Lucaxc/Master-Thesis-PtCO2/PCB/Board2.png

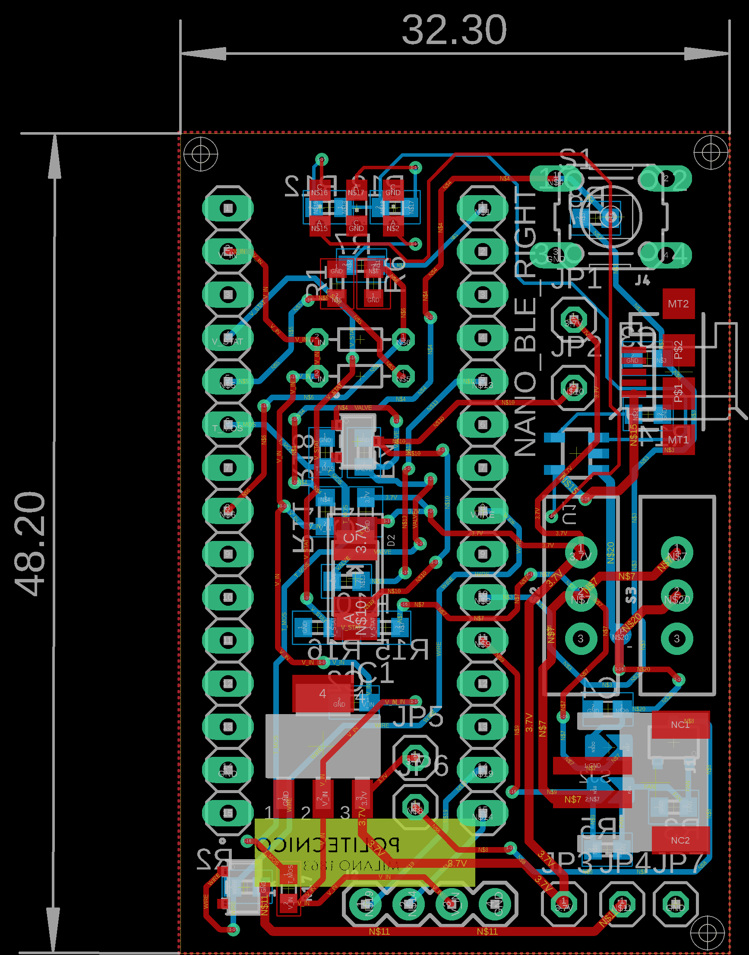
PCB/Board2.png
