Lucaxc/Master-Thesis-PtCO2/PCB/Ver_9.sch

## EAGLE design PCB/Ver_9.sch (2022-05-16)

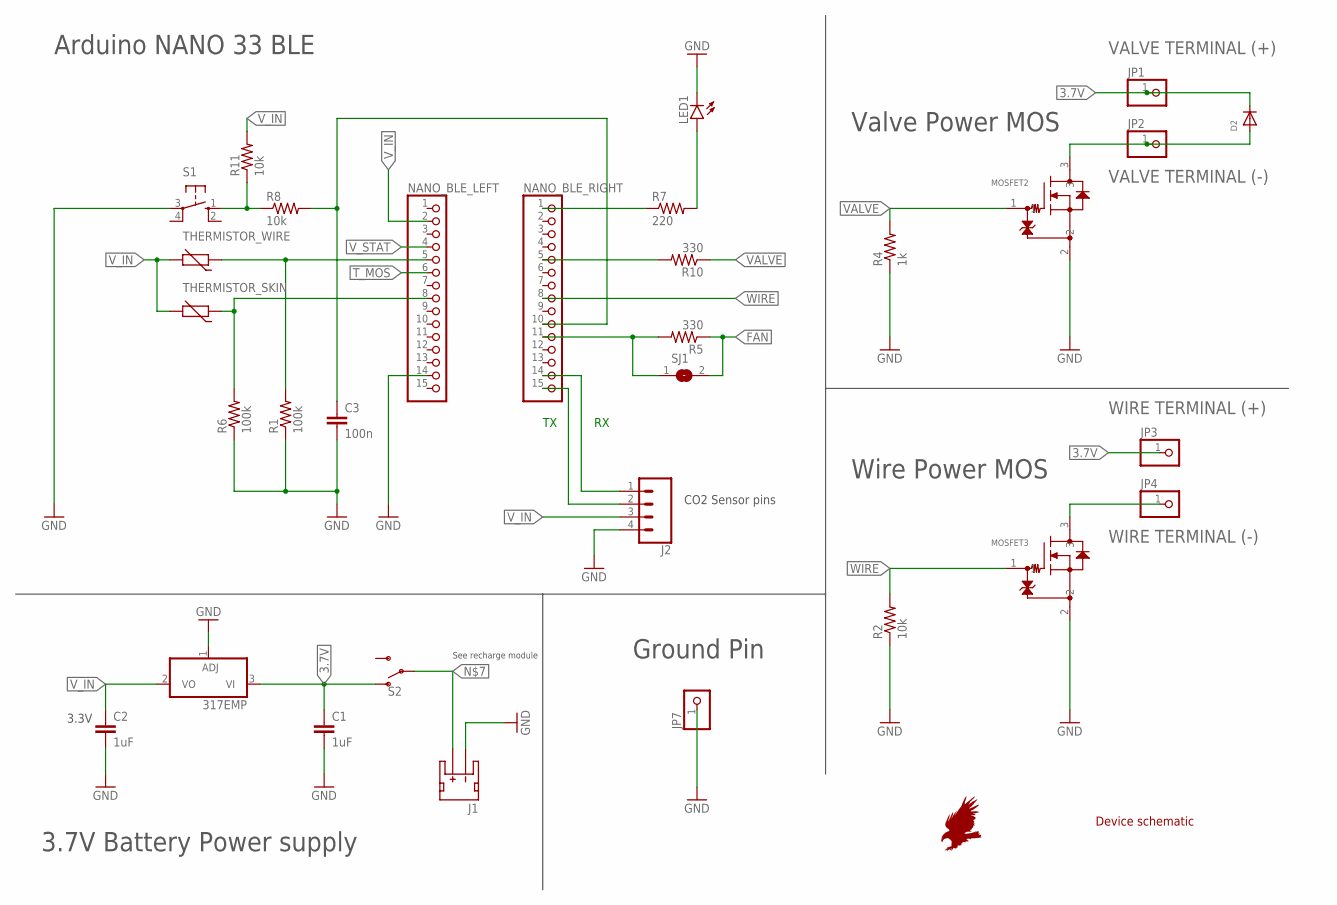
[picture p2: schematic Ver_9.sch, sheet 1]

Parts:
C1, C2: 1uF; C0603
C3: 100n; C0603
D2: DIODESMA; SMADIODE
IC1: 317EMP; SOT223
J1: JST_2MM_MALE; JST-2-SMD
J2: CONN_04; 1X04
JP1, JP2, JP3, JP4, JP7: PINHD-1X1; 1X01
LED1: LEDCHIPLED_0805; CHIPLED_0805
MOSFET2, MOSFET3: SSM3K2615RSOT-23F_TOS-M; SOT-23F_TOS-M
NANO_BLE_LEFT: PINHD-1X15; 1X15
NANO_BLE_RIGHT: PINHD-1X15; 1X15
R1, R6: 100k; R0603
R2, R8, R11: 10k; R0603
R4: 1k; R0603
R5, R10: 330; R0603
R7: 220; R0603
S1: 10-XX; B3F-10XX
S2: SWITCH-SPDT-PTH-11.6X4.0MM; SWITCH_SPDT_PTH_11.6X4.0MM
SJ1: SOLDERJUMPER; SOLDERJUMPER_ARROW_NOPASTE
THERMISTOR_SKIN: THERMISTOR-5; R-5
THERMISTOR_WIRE: THERMISTOR-5; R-5

Connections:
3.7V: C1.1, D2.C, IC1.3 (VI), JP1.1, JP3.1, S2.1 (O)
FAN: R5.1, SJ1.2
GND: C1.2, C2.2, C3.2, IC1.1 (ADJ), J1.1 (-), J2.4, JP7.1, LED1.C, MOSFET2.2, MOSFET3.2, NANO_BLE_LEFT.14, R1.1, R2.1, R4.1, R6.1, S1.3
unnamed: NANO_BLE_RIGHT.1, R7.1
unnamed: LED1.A, R7.2
unnamed: C3.1, NANO_BLE_RIGHT.10, R8.2
unnamed: R8.1, R11.1, S1.1 (S)
unnamed: NANO_BLE_LEFT.5, R1.2, THERMISTOR_WIRE.1
unnamed: NANO_BLE_LEFT.8, R6.2, THERMISTOR_SKIN.1
unnamed: J1.2 (+), S2.2
unnamed: NANO_BLE_RIGHT.11, R5.2, SJ1.1
unnamed: D2.A, JP2.1, MOSFET2.3
unnamed: JP4.1, MOSFET3.3
unnamed: NANO_BLE_RIGHT.5, R10.2
unnamed: J2.2, NANO_BLE_RIGHT.15
unnamed: J2.1, NANO_BLE_RIGHT.14
T_MOS: NANO_BLE_LEFT.6
VALVE: MOSFET2.1, R4.2, R10.1
V_IN: C2.1, IC1.2 (VO), J2.3, NANO_BLE_LEFT.2, R11.2, THERMISTOR_SKIN.2, THERMISTOR_WIRE.2
V_STAT: NANO_BLE_LEFT.4
WIRE: MOSFET3.1, NANO_BLE_RIGHT.8, R2.2

Notes on the sheet:
VALVE TERMINAL (+)
VALVE TERMINAL (-)
WIRE TERMINAL (+)
WIRE TERMINAL (-)
Valve Power MOS
Wire Power MOS
Arduino NANO 33 BLE
Ground Pin
3.3V
CO2 Sensor pins
3.7V Battery Power supply
Device schematic
See recharge module

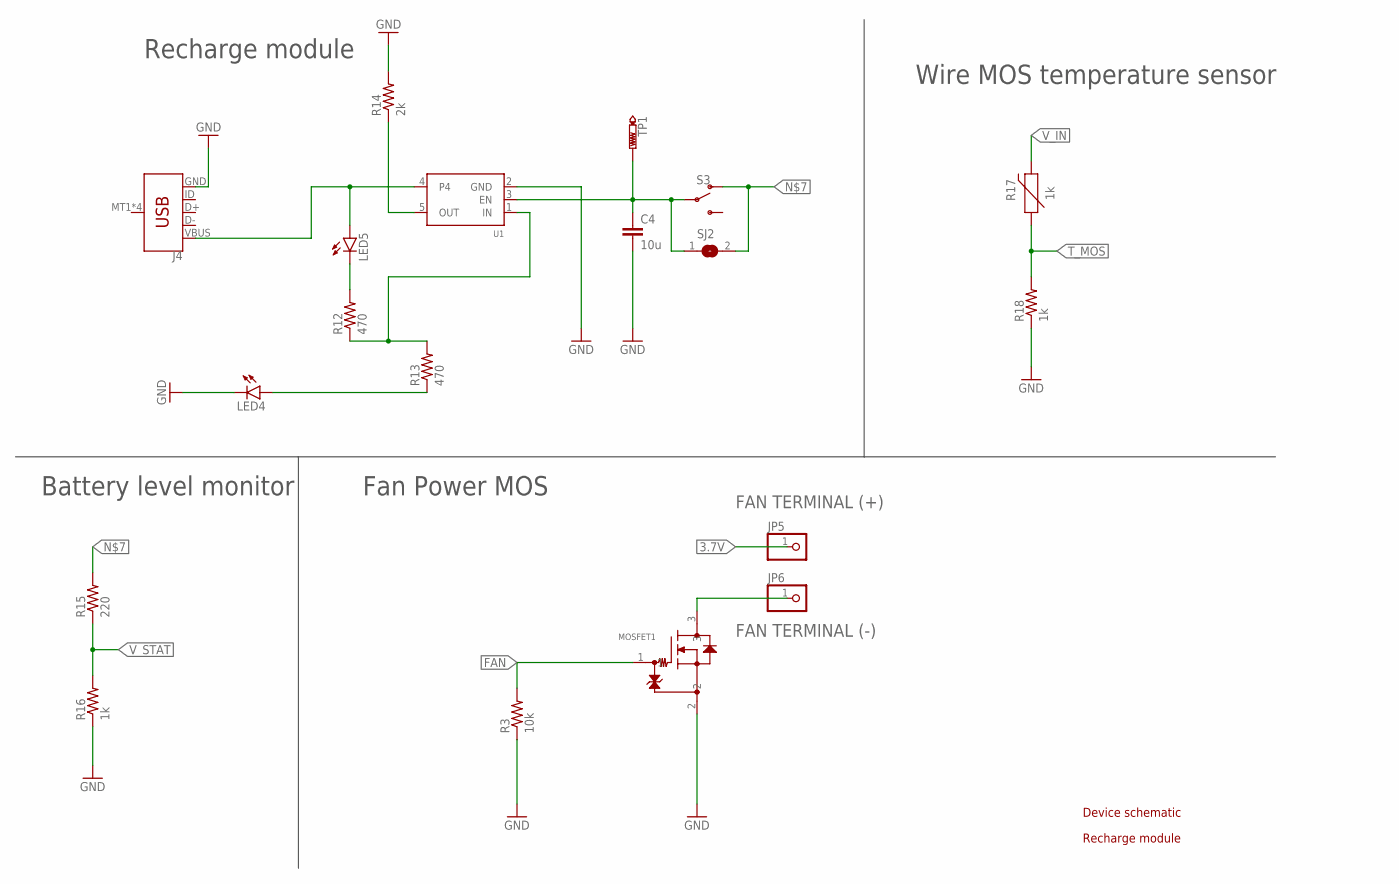
[picture p3: schematic Ver_9.sch, sheet 2]

Parts:
C4: 10u; C0603
J4: USB_MICRO-B_SMT; USB-MICROB
JP5, JP6: PINHD-1X1; 1X01
LED4, LED5: LEDCHIPLED_0805; CHIPLED_0805
MOSFET1: SSM3K2615RSOT-23F_TOS-M; SOT-23F_TOS-M
R3: 10k; R0603
R12, R13: 470; R0603
R14: 2k; R0603
R15: 220; R0603
R16, R18: 1k; R0603
R17: 1k; 0603
S3: SWITCH-SPDT-PTH-11.6X4.0MM; SWITCH_SPDT_PTH_11.6X4.0MM
SJ2: SOLDERJUMPER; SOLDERJUMPER_ARROW_NOPASTE
TP1: PTR1B1,27; B1,27
U1: VREG_SOT23-5; SOT23-5

Connections:
3.7V: JP5.1
FAN: MOSFET1.1, R3.2
GND: C4.2, J4.GND, LED4.C, MOSFET1.2, R3.1, R14.2, R16.1, R18.1, U1.2 (GND)
unnamed: R15.2, S3.1 (O), SJ2.2
unnamed: JP6.1, MOSFET1.3
unnamed: J4.VBUS, LED5.A, U1.4
unnamed: LED5.C, R12.2
unnamed: LED4.A, R13.1
unnamed: R12.1, R13.2, U1.1 (IN)
unnamed: C4.1, S3.2, SJ2.1, TP1.TP, U1.3 (EN)
unnamed: R14.1, U1.5 (OUT)
T_MOS: R17.1, R18.2
V_IN: R17.2
V_STAT: R15.1, R16.2

Notes on the sheet:
Device schematic
Recharge module
Battery level monitor
Wire MOS temperature sensor
Fan Power MOS
FAN TERMINAL (+)
FAN TERMINAL (-)
