Lucaxc/Master-Thesis-PtCO2/(commit log)

2022-05-16 PCB Added
    [Ver_9.sch]
2022-05-26 Added PCB device boxplots
2022-05-26 Boxplot working and deltas computation on PCB and Sentec Dataframe
2022-05-27 Radar plot script added
    [Data_for_radarplot.csv]
2022-08-13 Added Butterworth filtering to CO2 data and maximum extraction
